swholmstead/SkidSteer/README.md

<h1>3D printed RC Skidsteer</h1>
<div style="display: flex; gap: 20px;">
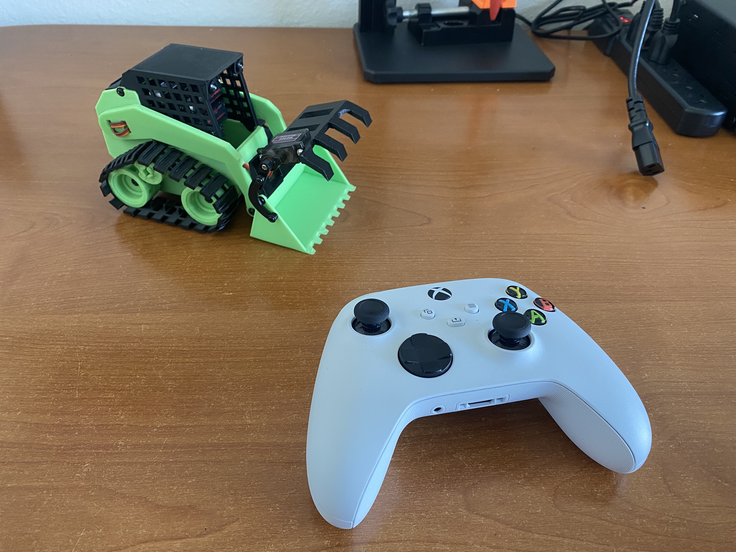
[picture p1: pictures/IMG_3390.JPEG]
  
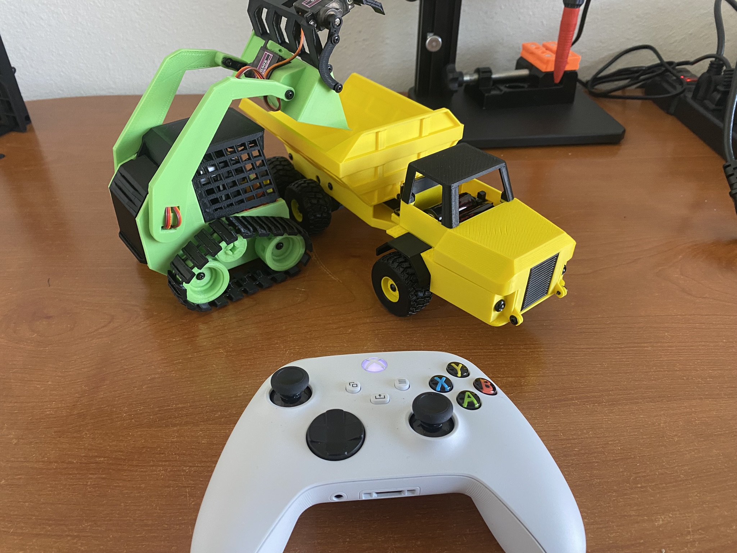
[picture p2: pictures/IMG_3392.JPEG]
  
</div>

<h2>Table of Contents</h2>

* [3D Models](https://www.printables.com/model/1399802-3d-printed-rc-skidsteer)
* [Bill of Materials](docs/bom.md)
* [Schematic and Printed Circuit Board](docs/schematics.md)
* [Assembly Instructions](docs/assembly.md)
* [Arduino IDE and Software](docs/arduino.md)

List of supported game controllers can be found here: [https://bluepad32.readthedocs.io/en/latest/supported_gamepads/](https://bluepad32.readthedocs.io/en/latest/supported_gamepads/)
