swholmstead/SkidSteer/docs/assembly.md

<h2>Assembly Instructions</h2>

<h3>Wheels</h3>

Solder 10 cm of wire with JST-XH connector to N20 12V motors.  Push on 2 drive shafts and 1 pinion gear onto motors.

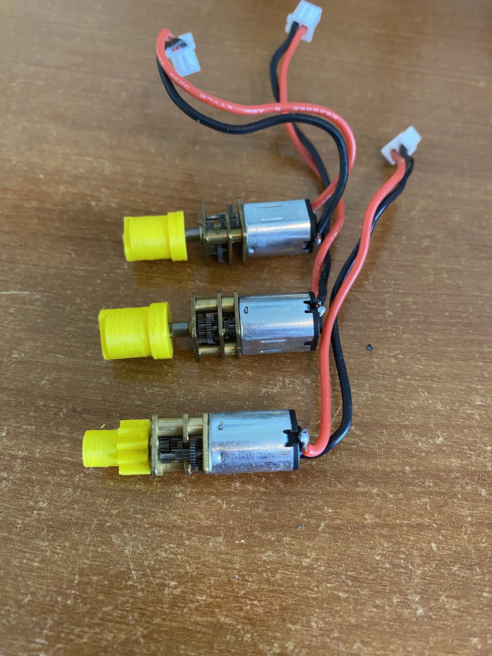
[picture p13: pictures/IMG_3649.JPEG]


Push in all 4 6700-2RS bearings and secure with M2.6 x 6mm bearing retention screws.

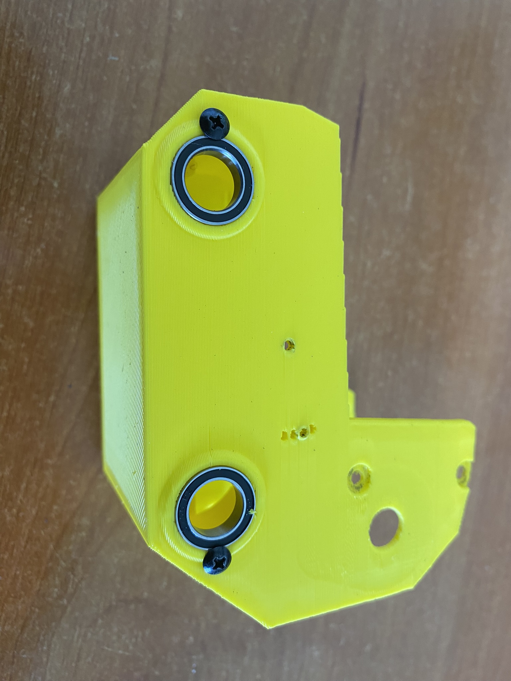
[picture p14: pictures/IMG_3650.JPEG]


Insert blank drive shafts and motors with drive shafts through bearings and secure motor with motor lock and M2.6 x 6mm screws.
The right motor is in the front and the left motor is in the rear.

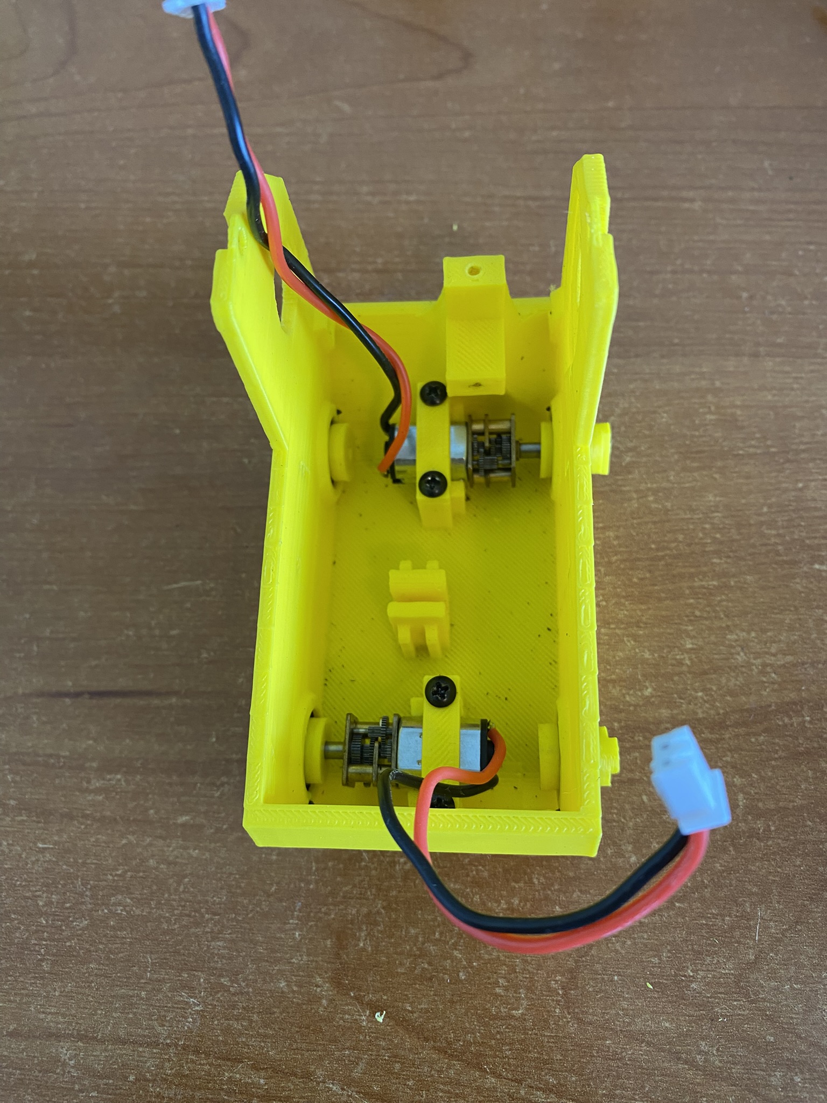
[picture p15: pictures/IMG_3651.JPEG]


Attach a wheel spacer and a wheel hub to each drive shaft and secure with M2.6 x 8mm screws.
You may need to drill out the single layer of support material in each wheen hub.

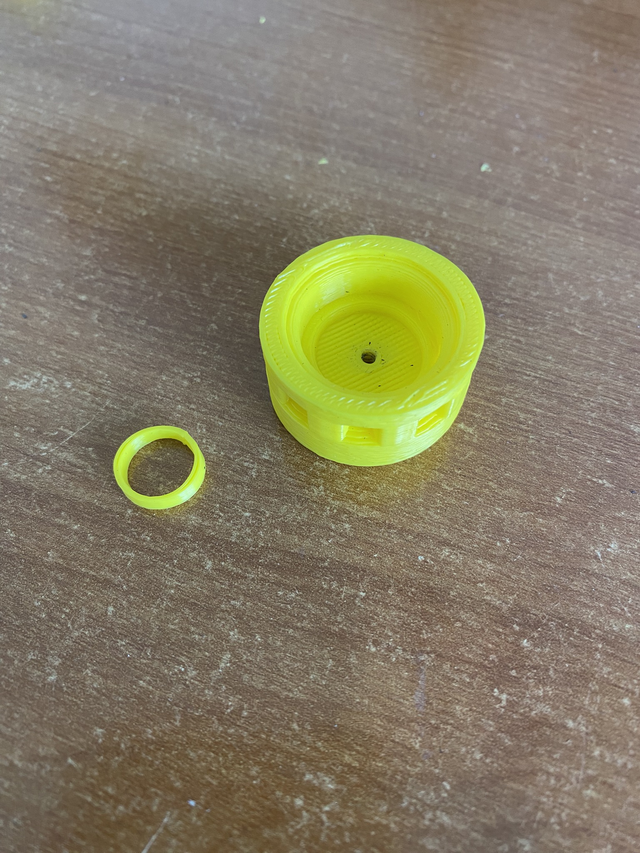
[picture p16: pictures/IMG_3654.JPEG]

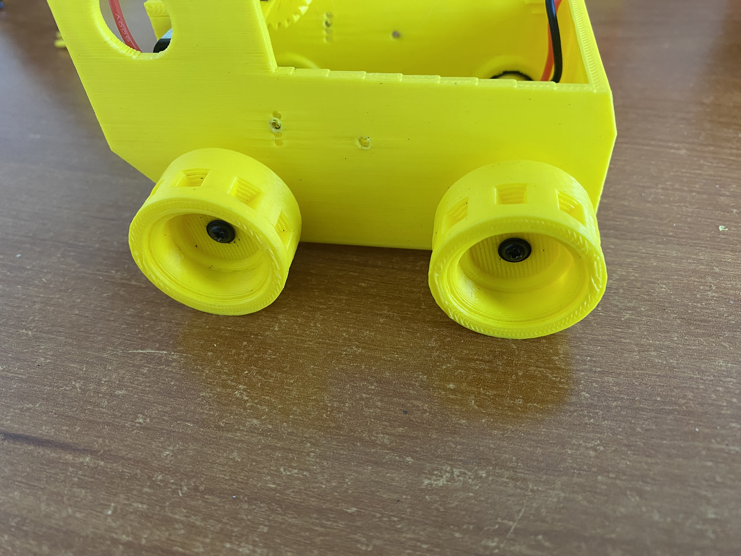
[picture p17: pictures/IMG_3655.JPEG]


<h3>Arm Gears</h3>

Attach the intermediate arm gear to the arm motor lock with an M2.6 x 8mm screw.

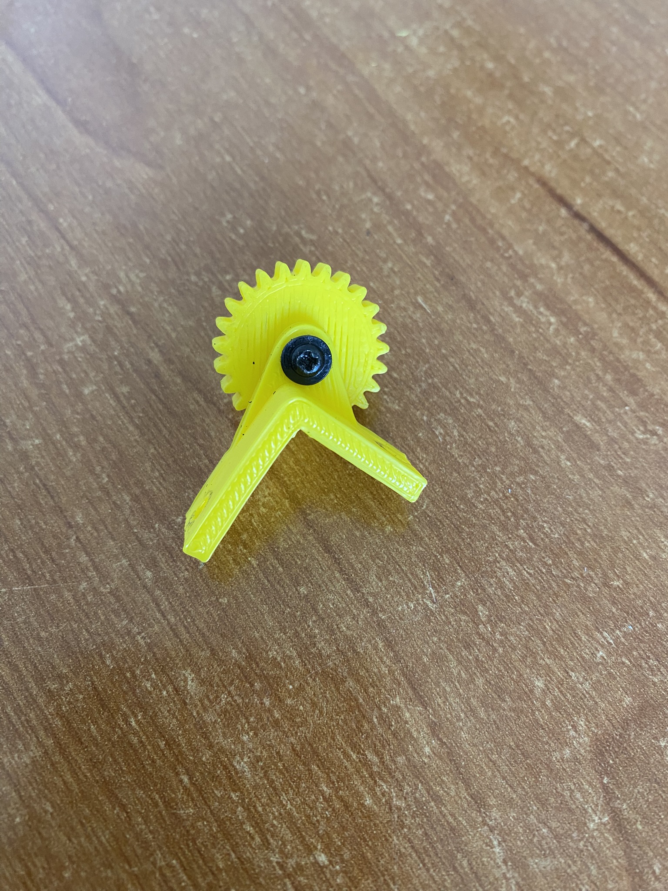
[picture p18: pictures/IMG_3652.JPEG]


Insert gears into body and secure arm motor with arm motor lock.  Add an M2.6 x 6mm screw on the outside of the body to the intermediate gear.

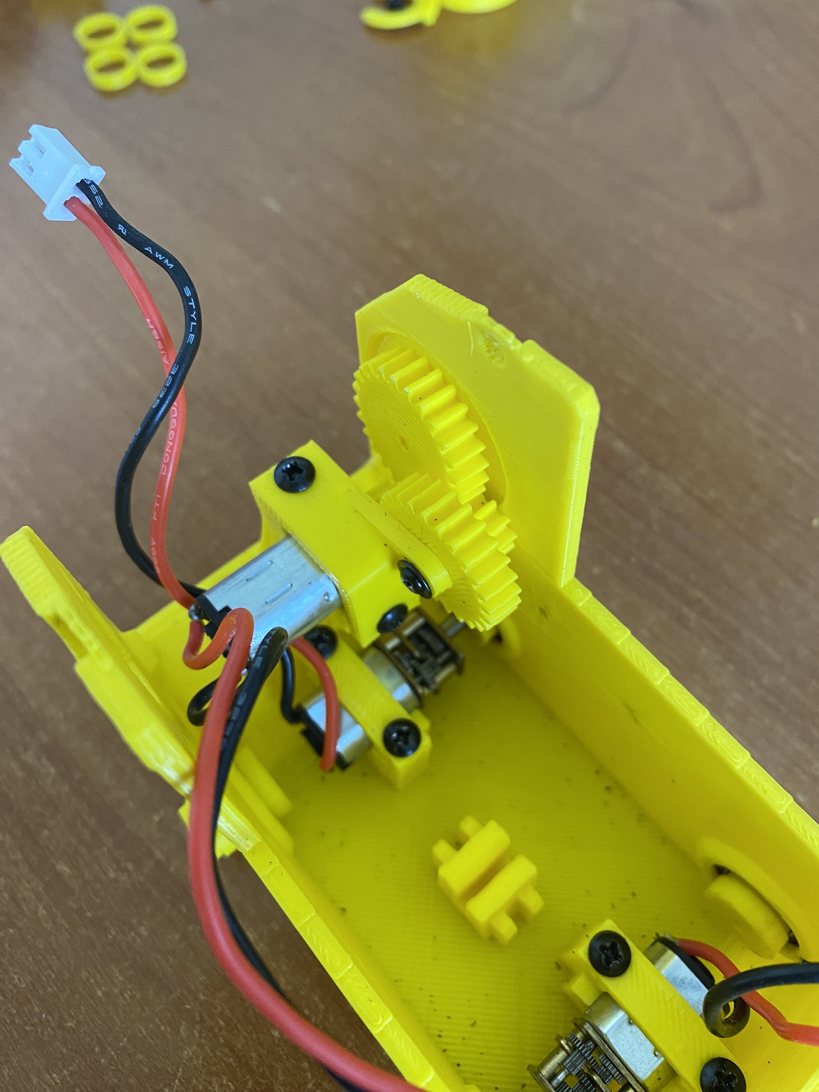
[picture p19: pictures/IMG_3653.JPEG]


Attach track tensioners to each side of cab with 2 M2.6 x 6mm screws.  There are multiple holes to adjust tension on tracks.
I like to use the second hole from the top.

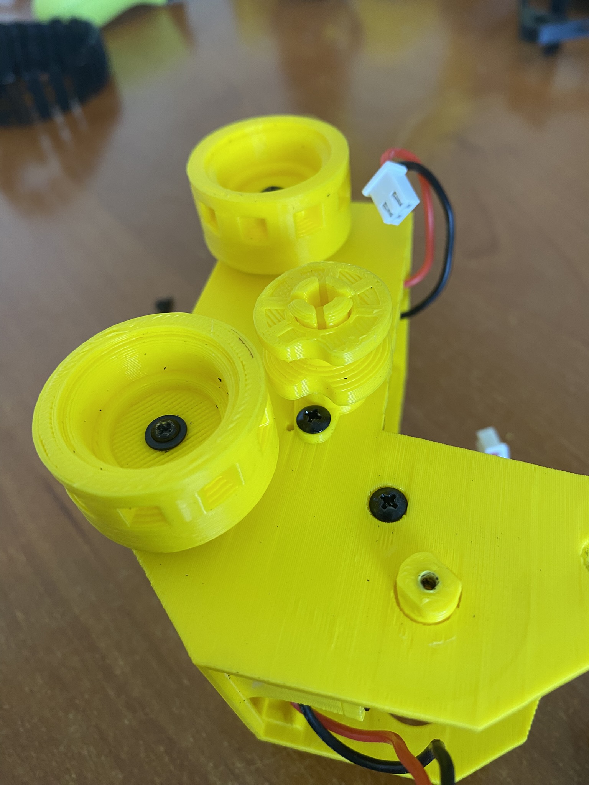
[picture p20: pictures/IMG_3656.JPEG]


<h3>Bucket and Claw</h3>

Attach the 9g servos to the bucket and claw with claw bracket.  Allow a little slack in the servo wires to allow
for full movement.  Route wires along right arm.

When attaching the servos, you need to align them so that the starting position has the bucket sitting level with the ground.
The starting position for the claw is all the way open.  You may need to return later and adjust servo starting positions
after the electonics are complete and installed to ensure that claw opens/closes all the way and the bucket doesn't
bind up when fully up.

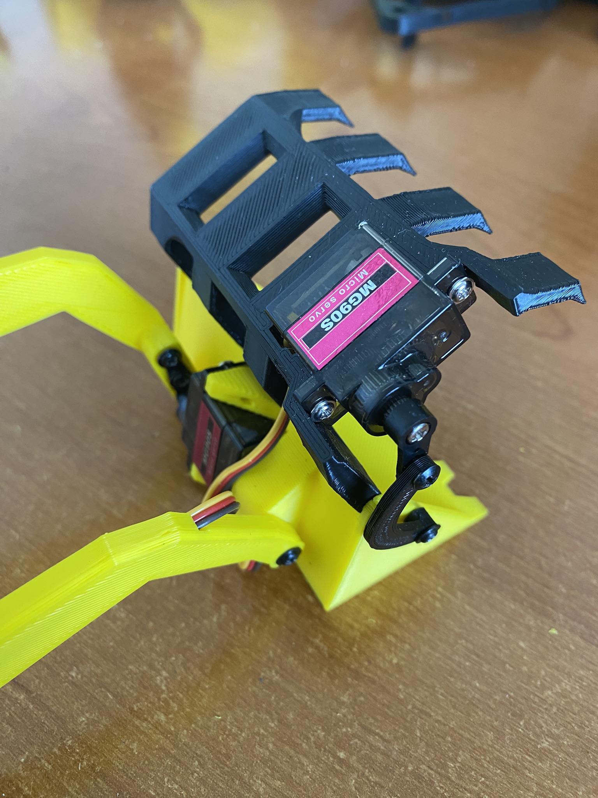
[picture p21: pictures/IMG_3657.JPEG]

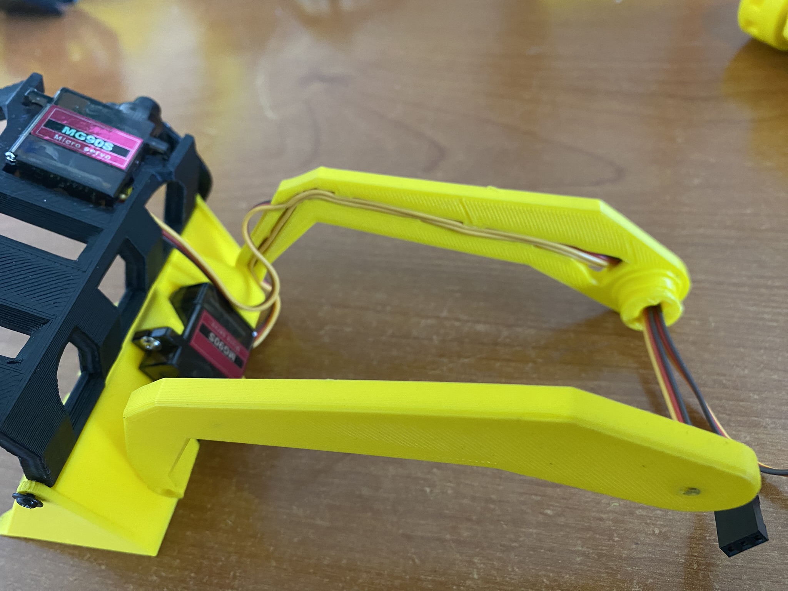
[picture p22: pictures/IMG_3658.JPEG]


Insert right arm into body and secure with C clip.

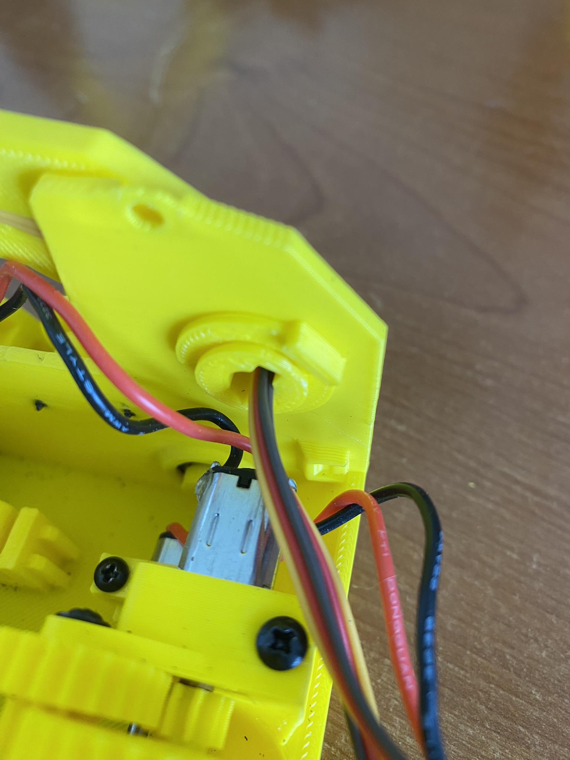
[picture p23: pictures/IMG_3659.JPEG]


Insert left arm into body and secure with M2.6 x 8mm screw.

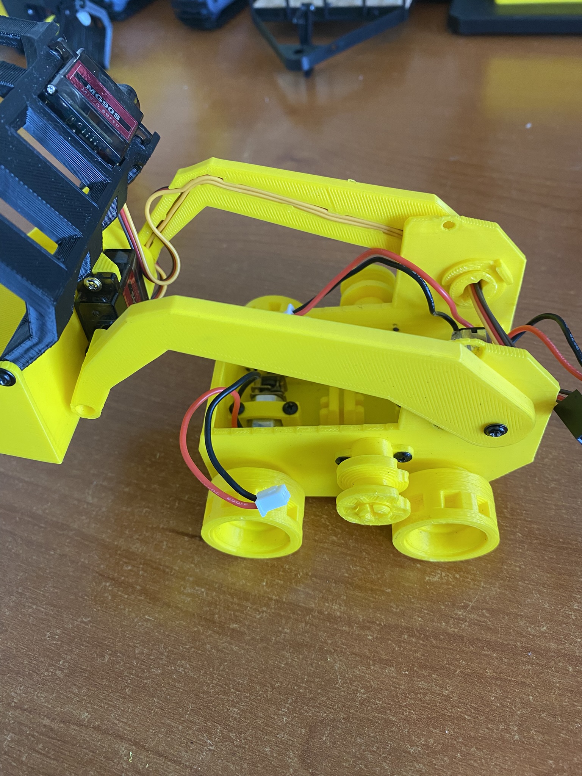
[picture p24: pictures/IMG_3660.JPEG]


<h3>Electronics</h3>

Attach right motor on front side of PCB.  Locate PCB support clip in bottom of body.  Insert PCB into body.

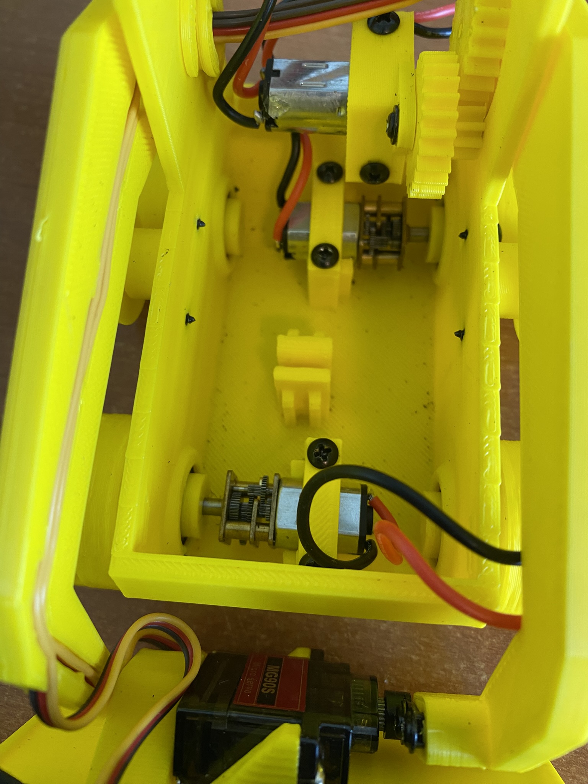
[picture p25: pictures/IMG_3661.JPEG]

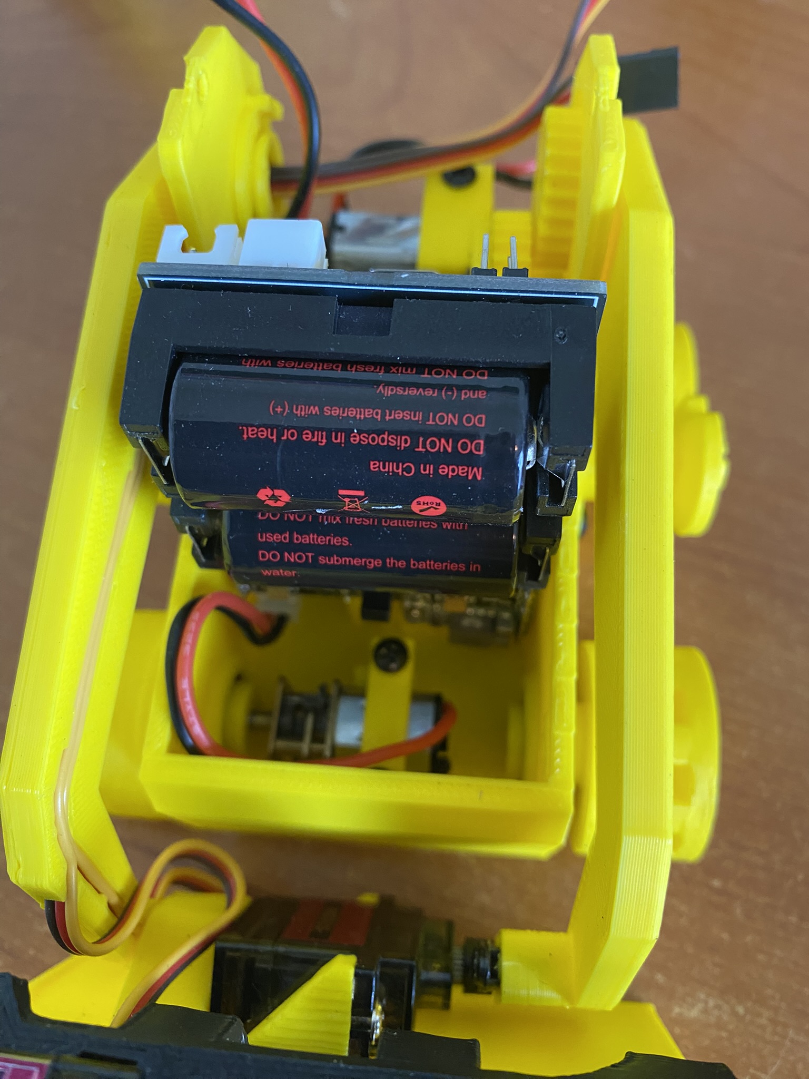
[picture p26: pictures/IMG_3662.JPEG]


Attach claw and bucket servos with brown wire to the TOP.  Attach left motor and arm motor to PCB.

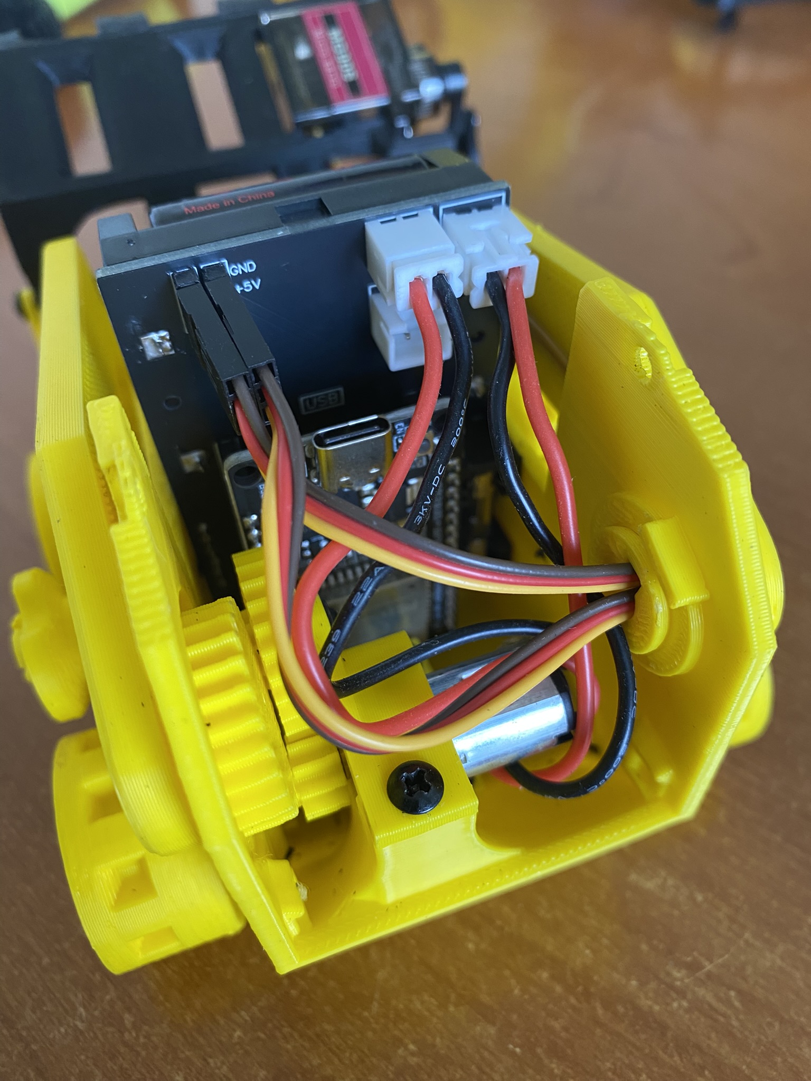
[picture p27: pictures/IMG_3663.JPEG]


<h3>Cab</h3>

Solder 100mm of wire with JST-XH to LEDs.  Insert LED retaining clip and LED into each side of cab cover.  Attach lights to PCB.

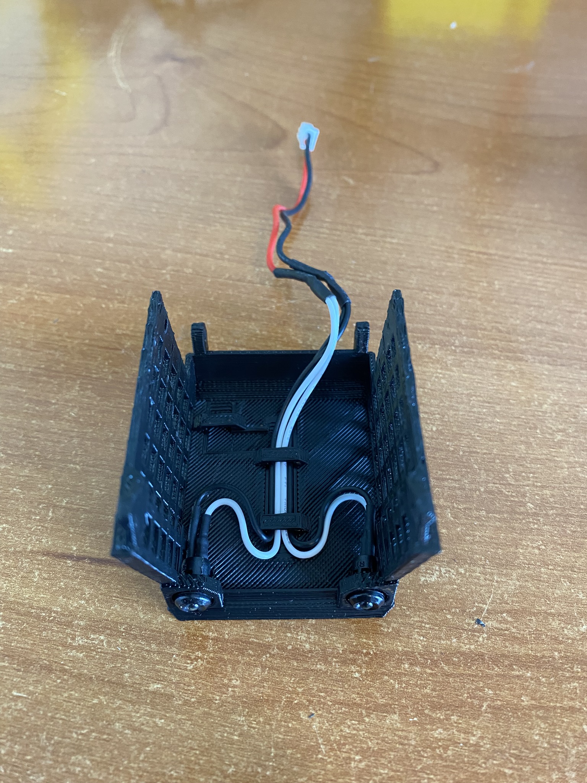
[picture p28: pictures/IMG_3648.JPEG]

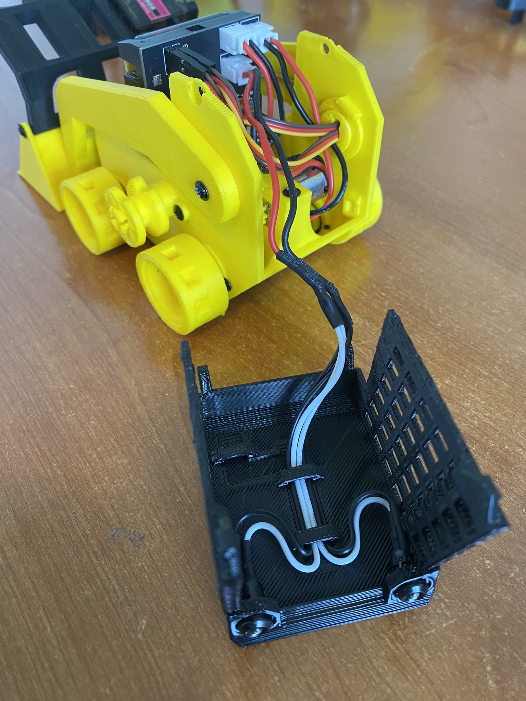
[picture p29: pictures/IMG_3664.JPEG]


Attach cab cover and rear cover to body with M2.6 x 10mm screws.  Add tracks.

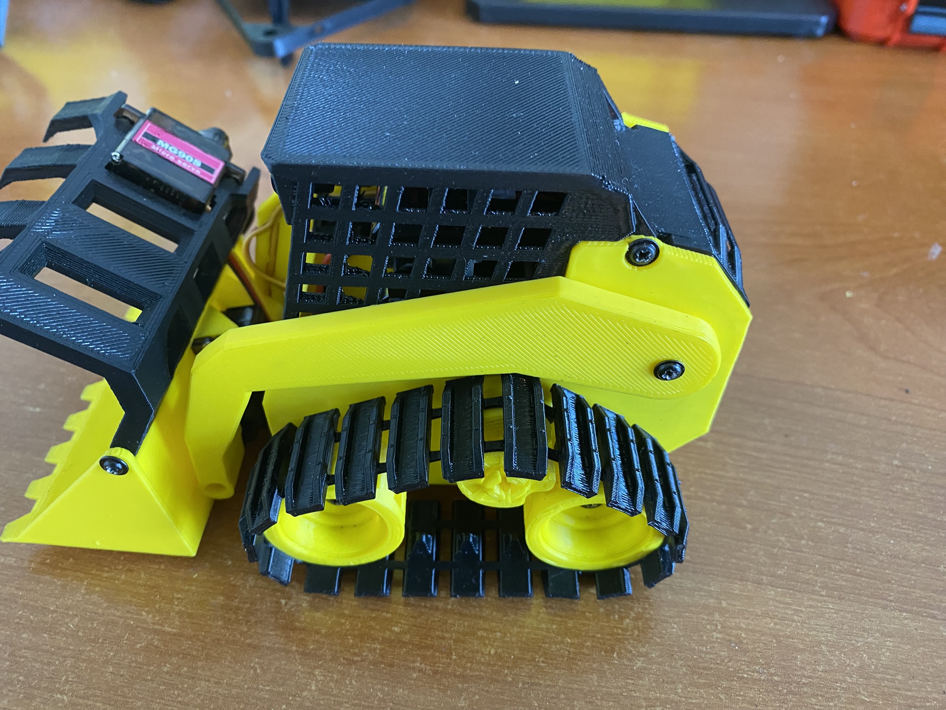
[picture p30: pictures/IMG_3665.JPEG]

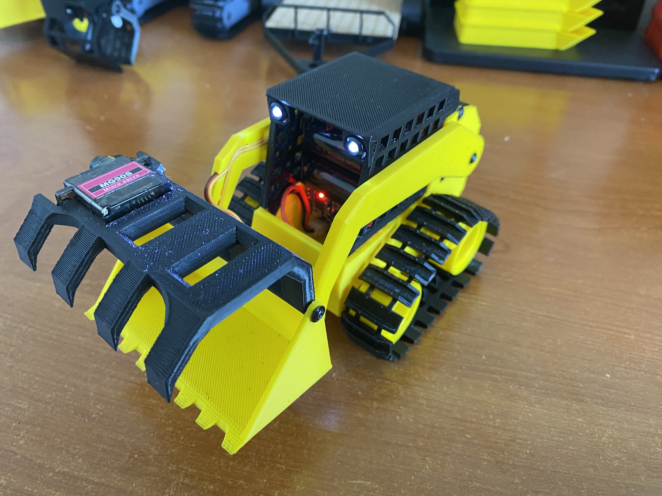
[picture p31: pictures/IMG_3666.JPEG]
