swholmstead/SkidSteer/(threads)

Thread 1 (2025-05-30):

PCB BOM request

e1kr, 2025-05-30:
Hi,

Thanks very much for sharing your version of the Mini Skid Steer controller PCB. Could you please also share your BOM and/or share a couple of pictures of the PCB to help with assembly.

Thanks again!

swholmstead, 2025-05-30:
Professor Boots already has instructions on [Professor Boots Workshop](https://professorboots.com/a/members/650f3661-3359-4cfb-adc2-71cbb8fea447/b40cabd7-99cf-40b4-a789-328ce7fec3da).

Closed 2025-08-30.
