swholmstead/SkidSteer/(commit log)

2025-01-27 Create Gerber Skid Steer PCB 44mm.zip
2025-01-28 Disallow multiple BT connections
    Prevents multiple controllers from connecting to the same vehicle.
    [MiniSkidi_Bluepad_2.0.ino]
2025-02-24 Moved bucket to right X axis
2025-03-06 Fixed throttle dead zone and added low gear
    [MiniSkidi_Bluepad_2.0.ino]
2025-08-30 Updated arduino.md and bom.md
2025-08-30 Updated assembly.md
2025-08-30 renamed schematics file
2025-08-30 change PCB and schematics to png files
2025-08-30 Updated schematics
2025-08-30 Added assembly instructions
2025-08-31 Reversed polarity on right track motor
    [MiniSkidi_Bluepad_2.0.ino]
2025-09-10 Check +5V picture
2025-09-27 Also control claw with left/right bumper
